ThatAquarel/6sens/docs/README.md

# 6sens

## L'équipe

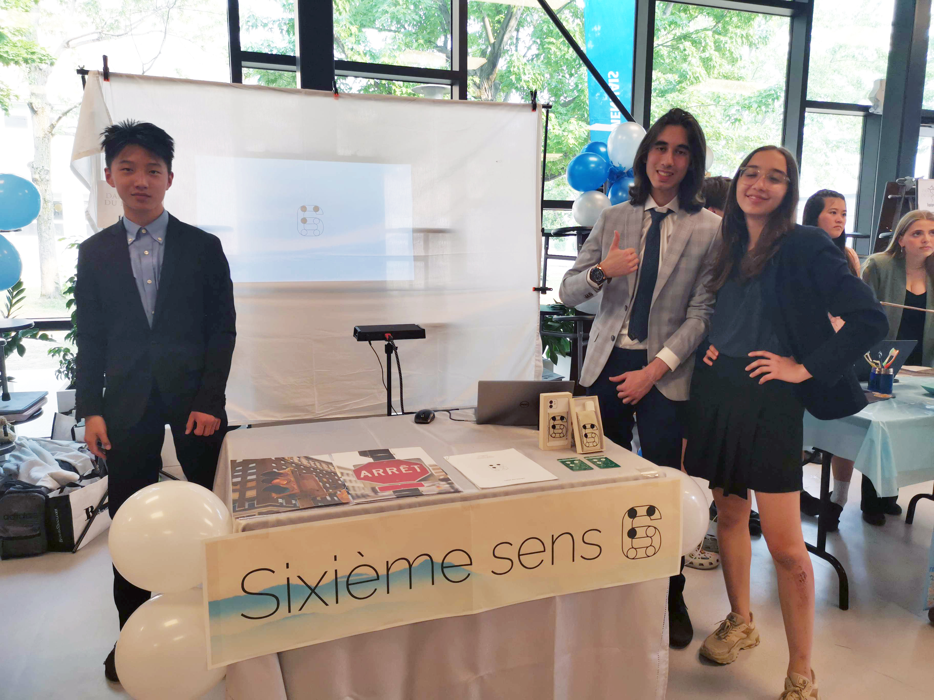
[picture p1: docs/equipe.jpg]
Équipe


- Tian Yi Xia<sup>1</sup> (Ingénierie et conception)
- Vlad Marinescu<sup>1</sup> (Finances et comptabilité)
- Jana El Samad<sup>1</sup> (Marketing et communications)

<sup>1</sup>Collège Jean de la Mennais, secondaire 4

## Une démonstration vidéo

- À 0min 0s - Description du projet
- À 0min 29s - Détection des obstacles avec l'intelligence artificielle
- À 0min 49s - Conception
- À 1min 9s - Assemblage

Démonstration du projet (https://youtu.be/_et0clgrfNw)

## Le projet

Le Sixième sens (6sens®) est une compagnie qui se focalise sur les personnes ayant des troubles de la vision nécessitant des besoins particuliers. C’est une minorité sous-représentée dans le monde, soit 284 millions de personnes selon l’Organisation de la santé dans le monde. Ceux-ci font face à de nombreuses difficultés en termes de navigation géographique, selon l’Organisation des infrastructures publiques ainsi que des difficultés à percevoir des obstacles approchant d’une distance (Glenk, et al. 2019). Malgré les avancées technologiques, les principales solutions offertes à leur disposition sont les cannes (utilisées 98% du temps) et les chiens accompagnateurs (utilisés 2% du temps) (Spinsante, et al. 2022). Cependant, ceux-ci ont leurs limitations en termes d’efficacité.

Notre premier modèle, le Sixième sens 6.1, est un étui pour téléphone qui aide les personnes non voyantes à naviguer et à s’orienter, et ce, en les aidant à localiser les objets dans un espace spatio-temporel. Par conséquent, il vise à remplacer ou à complémenter l’utilisation de la canne et du chien en s’appuyant sur leurs faiblesses.

Les objets détectés par la caméra du téléphone à laquelle le 6sens® est attaché sont, en effet, traités par notre logiciel qui permet de détecter plus de 90 obstacles différents. Le 6sens® effectue ensuite des vibrations coordonnées afin de traduire l’information visuelle en une rétroaction haptique sur la main de l’utilisateur. En bref, la personne non voyante peut ainsi «voir» avec ses mains.

## Le produit



En ce qui a trait à l'aspect physique, le modèle 6.1 est ergonomiquement adapté à un usage fréquent. Les moteurs sont stratégiquement placés en forme courbée afin d’épouser la forme d’une main standard qui est ainsi en position de capter l’ensemble des vibrations. La grandeur de l'accessoire est aussi conçue pour convenir à la taille de téléphones standard de notre époque, soit de 6,5 par 13 centimètres, de façon à ce qu’un utilisateur puisse commodément garder le même produit lorsqu'il change de téléphone. Le modèle 6.1 s’y attache également par des aimants. Une bande de tissu ajustable est aussi présente afin d’empêcher l’utilisateur d’échapper son cellulaire accidentellement. Celle-ci est beige, notre couleur de marque, qui offre un contraste net avec le logo, afin de le rendre plus reconnaissable. Cette poignée sert également d’indication de l’utilisation de l’outil par une personne aveugle, afin de ne pas laisser place à des malentendus en lieux publics. Par rapport à l’emballage, celui-ci est entièrement écrit en français, en anglais ainsi qu’en braille, afin de faciliter la compréhension du produit par tous. La boîte simpliste en forme de prisme à base rectangulaire est aussi beige, les couleurs de notre marque. Elle est surmontée d’une image de l'arrière d’un cellulaire avec notre produit, afin de donner une représentation juste pour les personnes voyantes, incluant les optométristes. Il en est de même pour le logo conçu pour le Sixième sens, qui est reconnaissable autant en braille que dans les autres langues courantes. Le numéro six est écrit autant en chiffres arabes qu’en braille, représenté par les points colorés.

## Documents supplémentaires

- [Présentation du projet](https://raw.githubusercontent.com/ThatAquarel/6sens/main/docs/fichiers/presentation.pdf)

- [Plan d'affaires](https://raw.githubusercontent.com/ThatAquarel/6sens/main/docs/fichiers/presentation.pdf)

- [Cahier des charges](https://raw.githubusercontent.com/ThatAquarel/6sens/main/docs/fichiers/cahier_charges.pdf)

## Bibliographie

- Lisa Maria Glenk (2019), https://pubmed.com, Perceptions on Health Benefits of Guide Dog Ownership in an Austrian Population of Blind People with and without a Guide Dog [En ligne], page consultée le 18 Mai 2023.

- Susanna Spinsante (2022), https://pubmed.com, Wearable Travel Aids for Blind and Partially Sighted People: A Review with a Focus on Design Issues, [En ligne], page consultée le 18 Mai 2023.

- Brailleworks (2022), https://brailleworks.com/social-media-for-the-visually-impaired/ , Social Media for the Visually Impaired, [En ligne], page consultée le 19 Mai 2023.

- Negar (2021)  https://colors.dopely.top/inside-colors/the-most-visible-colors-for-human-eyes, The Most Visible Colors For Human Eyes !, [En ligne], page consultée le 16 Mai 2023.

- Lisa Hoover McGreevy (2014) https://www.entrepreneur.com/business-news/how-you-should-be-marketing-to-the-visually-impaired/239352, How You Should Be Marketing to the visually impaired [En Ligne], page consultée le 13 Mai 2023.
