ThatAquarel/6sens/sixsens/audio/audio.md

# TTS Script

```
Champ de vision obstrué.

Attention!

Quelques personnes 
Une dizaine de personnes
Une vingtaine de personnes
Une trentaine de personnes
Une quarantaine de personnes
Une cinquantaine de personnes
Quelques dizaines de personnes

Intersection
Feux de circulation
Panneau d'arrêt

Voiture
Bus

Porte
Chaise
Table

Distances
    très proche
    à 10 mètres
    à 20 mètres
    à 30 mètres
    à 40 mètres
    à 50 mètres
    en périphérie

État
    immobile
    lente
    en excès de vitesse
```

```
<speak>
<emphasis level="moderate">Champ de vision obstrué.</emphasis>
<break time="1000ms"/>
<emphasis level="strong">Attention!</emphasis>
<break time="1000ms"/>
Quelques personnes...
<break time="1000ms"/>
Une dizaine de personnes...
<break time="1000ms"/>
Une vingtaine de personnes...
<break time="1000ms"/>
Une trentaine de personnes...
<break time="1000ms"/>
Une quarantaine de personnes...
<break time="1000ms"/>
Une cinquantaine de personnes...
<break time="1000ms"/>
Quelques dizaines de personnes...

<break time="1000ms"/>
Intersection...
<break time="1000ms"/>
Feux de circulation...
<break time="1000ms"/>
Panneau d'arrêt...
<break time="1000ms"/>

Voiture...
<break time="1000ms"/>
Bus...
<break time="1000ms"/>
Porte...
<break time="1000ms"/>
Chaise...
<break time="1000ms"/>
Table...

</speak>
```

```
<speak>
...très proche.
<break time="1000ms"/>
...à 10 mètres.
<break time="1000ms"/>
...à 20 mètres.
<break time="1000ms"/>

...à 30 mètres.
<break time="1000ms"/>
...à 40 mètres.
<break time="1000ms"/>
...à 50 mètres.
<break time="1000ms"/>
...en périphérie.
<break time="1000ms"/>

...immobile...
<break time="1000ms"/>
...lente...
<break time="1000ms"/>
...en excès de vitesse...

</speak>
```
