ThatAquarel/6sens/docs/haptic.png

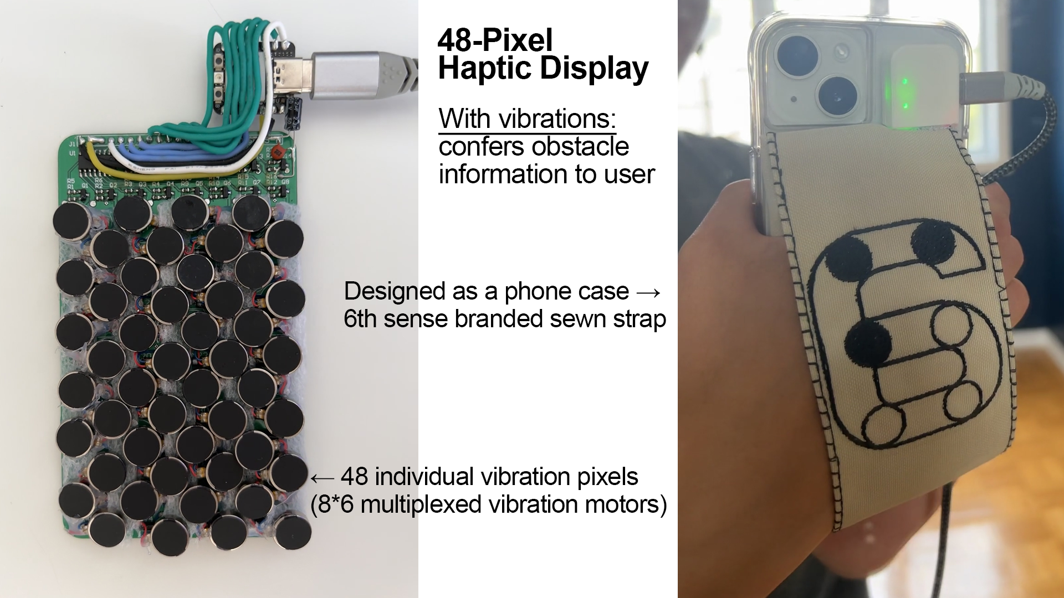
docs/haptic.png
