ThatAquarel/6sens/docs/jdlm.png

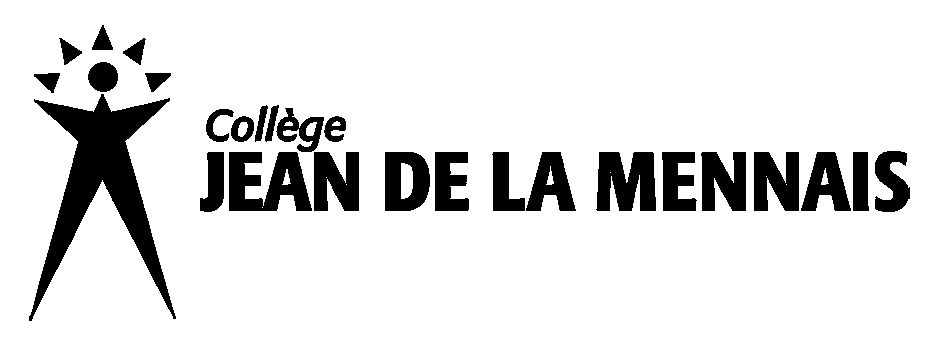
docs/jdlm.png
