ThatAquarel/6sens/media/product/MPU13.jpg

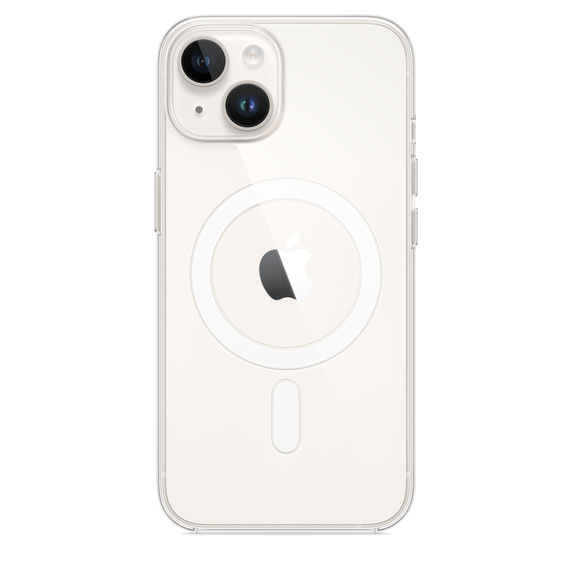
media/product/MPU13.jpg
