ThatAquarel/6sens/media/SCAN0325.JPG

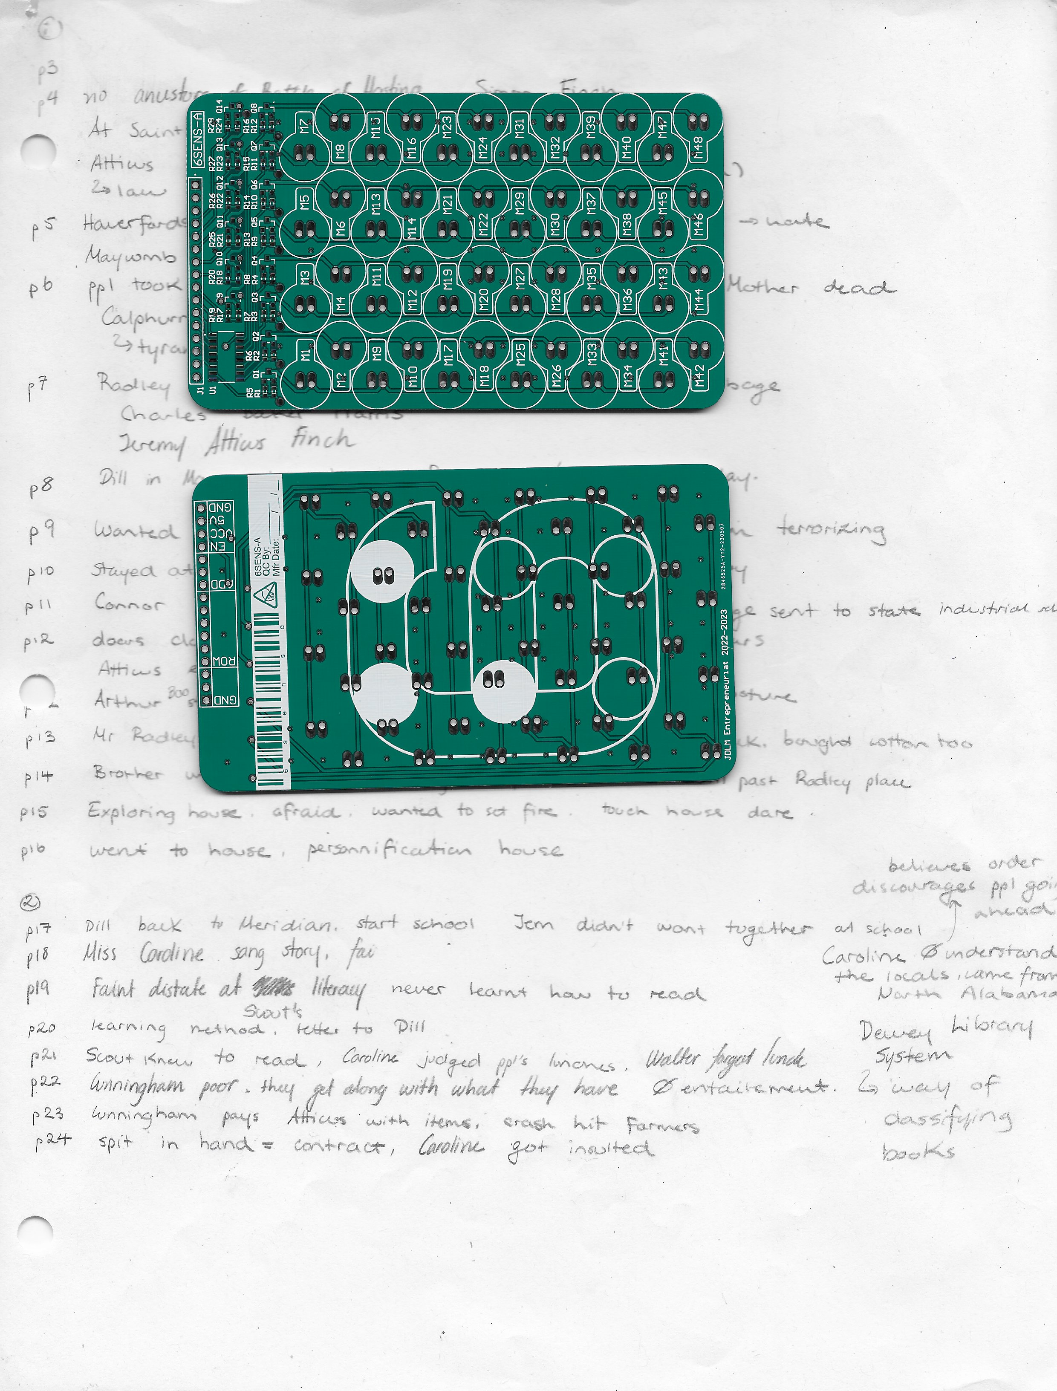
media/SCAN0325.JPG
