ThatAquarel/6sens/media/sea939.webp

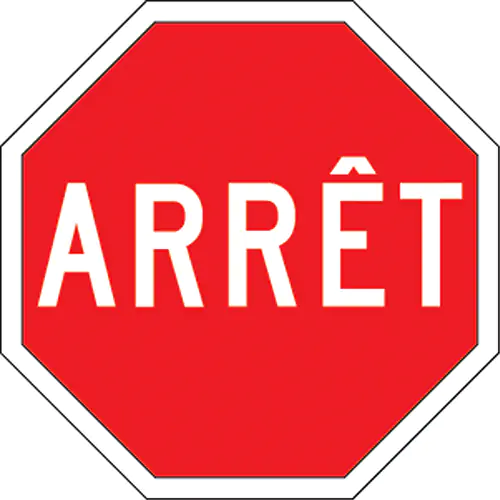
media/sea939.webp
