ThatAquarel/6sens/(list of files, drawings)

Other design files:
6thsense/6thsense.PrjPcb
6thsense/6thsense_lib.SchLib
6thsense/6thsense_pcb_lib.PcbLib
6thsense/main.PcbDoc
6thsense/main.SchDoc
6thsense/matrix.SchDoc
