ThatAquarel/6sens/drafts/yolov5.py

import cv2
import torch
import numpy as np

import torchvision.models.detection as det

# Model
model = torch.hub.load(
    "ultralytics/yolov5", "yolov5n"
)  # or yolov5n - yolov5x6, custom

# video_path = "./pedestrians.mp4"
cap = cv2.VideoCapture("/dev/video0")

# Loop through the video frames
while cap.isOpened():
    # Read a frame from the video
    success, frame = cap.read()

    if success:
        # Run YOLOv8 inference on the frame
        results = model(frame)

        # Visualize the results on the frame
        annotated_frame = results.render()[0]

        # Display the annotated frame
        cv2.imshow("YOLOv5 Inference", annotated_frame)

        # Break the loop if 'q' is pressed
        if cv2.waitKey(1) & 0xFF == ord("q"):
            break
    else:
        # Break the loop if the end of the video is reached
        break

# Release the video capture object and close the display window
cap.release()
cv2.destroyAllWindows()
