ThatAquarel/6sens/sixsens_hw/led_test/led_test.ino

#include <Adafruit_NeoPixel.h>

int Power = 11;
int PIN  = 12;
#define NUMPIXELS 1

Adafruit_NeoPixel pixels(NUMPIXELS, PIN, NEO_GRB + NEO_KHZ800);

void setup() {
  pixels.begin();
  pinMode(Power,OUTPUT);
  digitalWrite(Power, HIGH);

}

void loop() { 
  // pixels.clear();
  // pixels.setPixelColor(0, pixels.Color(15, 25, 205));
  // delay(400);
  // pixels.show();
  // pixels.clear();
  // pixels.setPixelColor(0, pixels.Color(103, 25, 205));
  // delay(400);
  // pixels.show();
  // pixels.clear();
  // pixels.setPixelColor(0, pixels.Color(233, 242, 205));
  // delay(400);
  // pixels.show();
  // pixels.clear();
  // pixels.setPixelColor(0, pixels.Color(233, 23, 23));
  // delay(400);
  // pixels.show();
  // pixels.clear();
  // pixels.setPixelColor(0, pixels.Color(12, 66, 101));
  // delay(400);
  // pixels.show();
  // delay(500);

  pixels.clear();
  pixels.setPixelColor(0, pixels.Color(255, 0, 0));
  pixels.show();
  delay(500);
  pixels.setPixelColor(0, pixels.Color(0, 0 ,0));
  pixels.show();
  delay(500);
}
