ThatAquarel/6sens/(commit log)

2023-05-03 altium files
    [6thsense.PrjPcb, 6thsense_lib.SchLib, 6thsense_pcb_lib.PcbLib, main.PcbDoc, main.SchDoc, matrix.SchDoc]
2023-05-05 diminish 6 rows
    [main.PcbDoc, main.SchDoc, matrix.SchDoc]
2023-05-06 routed pcb
    [6thsense.PrjPcb, 6thsense_pcb_lib.PcbLib, main.PcbDoc, main.SchDoc]
2023-05-15 export pdf
    [6thsense.PrjPcb, main.SchDoc, matrix.SchDoc]
2023-05-21 rename audio track
2023-05-28 fix framerate
